tom63005/APF2SD/img/APF2SD-Fron-Back-Bare-G_20131016_144659.jpg

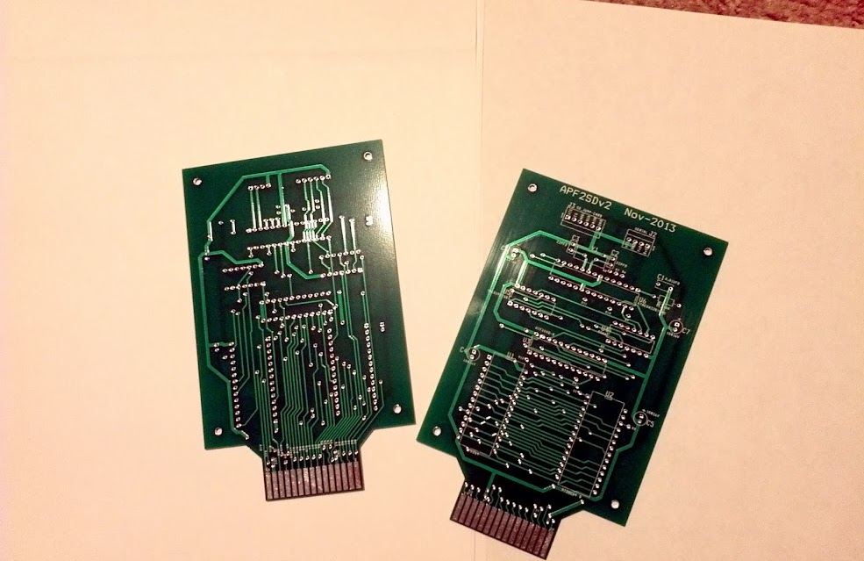
img/APF2SD-Fron-Back-Bare-G_20131016_144659.jpg
