tom63005/APF2SD/img/ShellP1.JPG

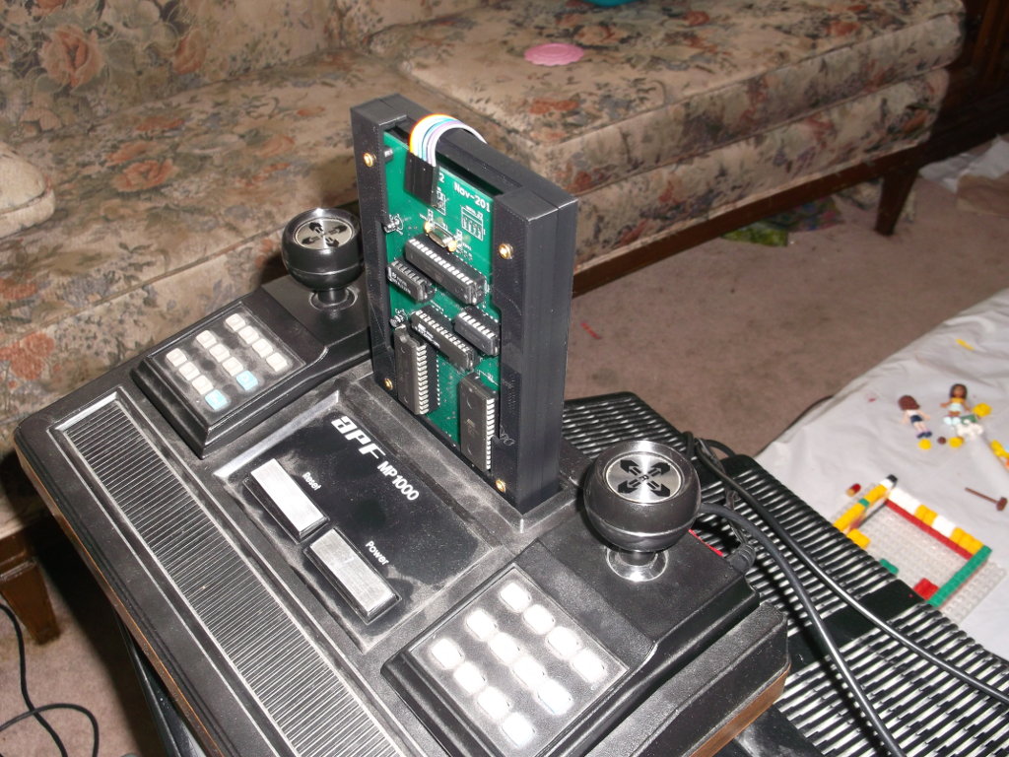
img/ShellP1.JPG
