tom63005/APF2SD/img/2layer-r1---for-Lance-gs.png

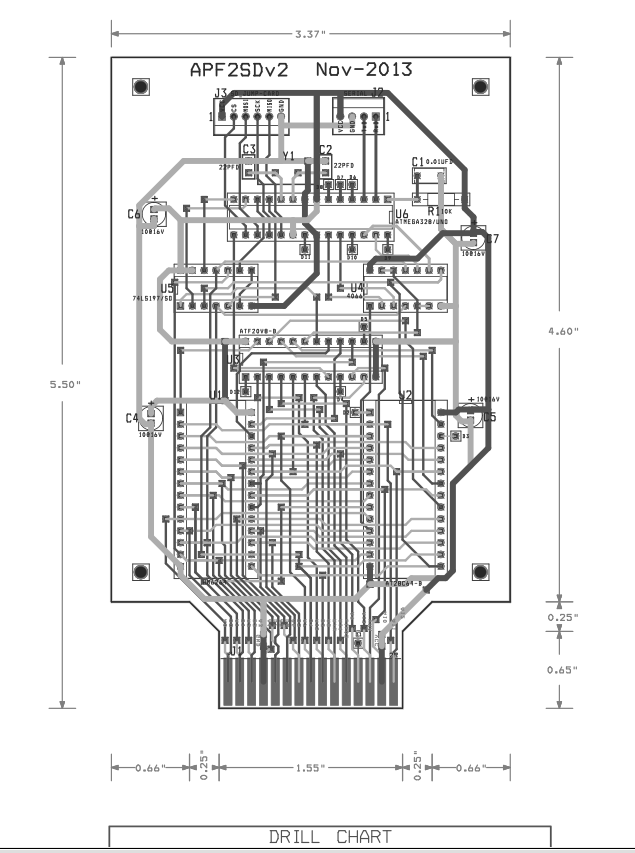
img/2layer-r1---for-Lance-gs.png
