tom63005/APF2SD/img/APF2SD-Schematic-Sept-23-2013.jpg

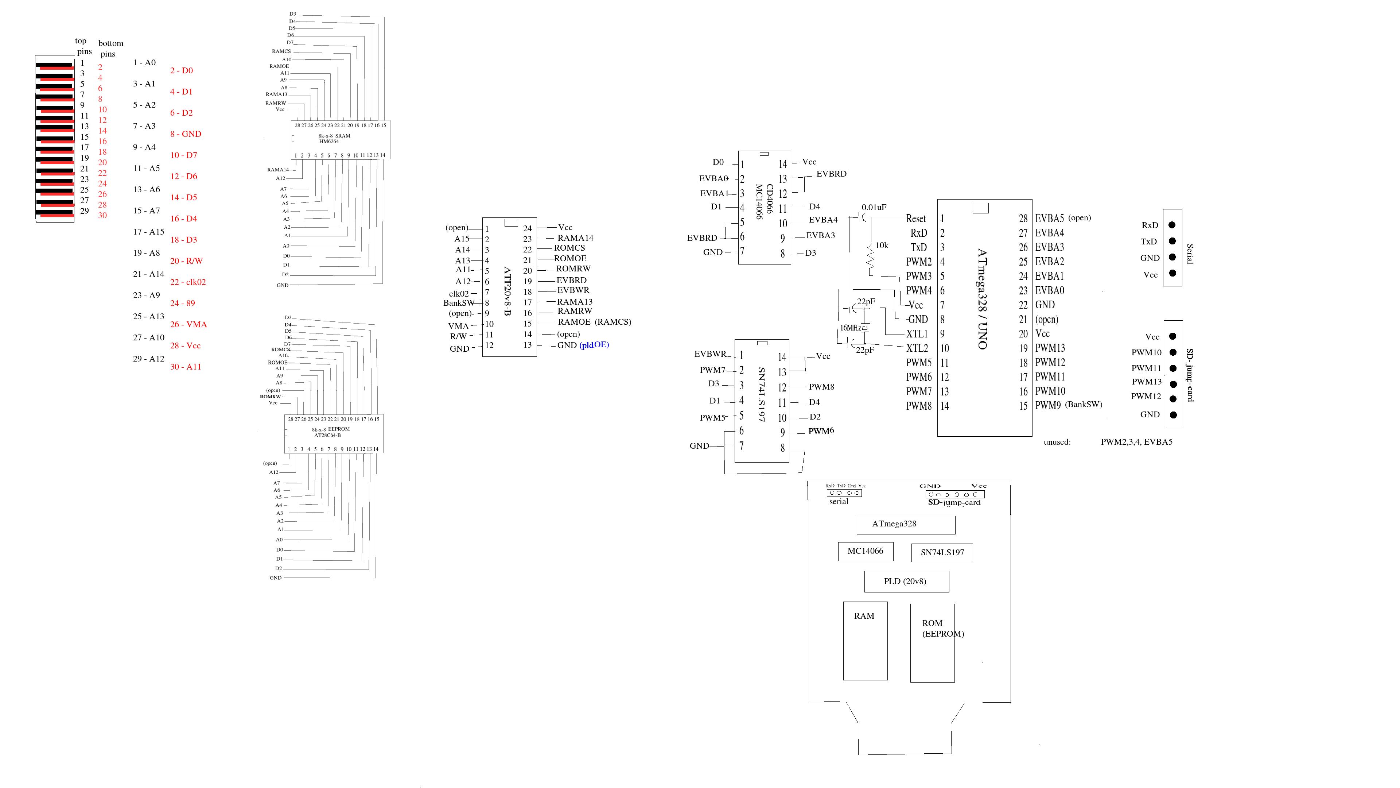
img/APF2SD-Schematic-Sept-23-2013.jpg
