tom63005/APF2SD/img/IMG_20131017_115455.jpg

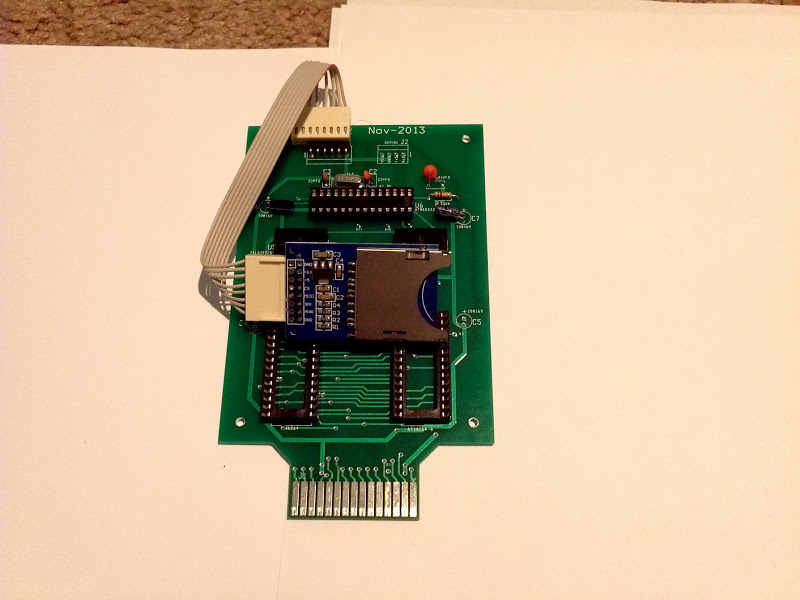
img/IMG_20131017_115455.jpg
