tom63005/APF2SD/img/SD-Serial-SST-09-28-2013-11h_35m_43s-AM.jpg

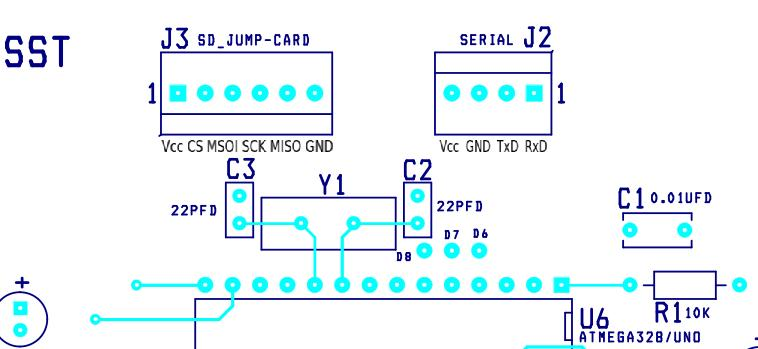
img/SD-Serial-SST-09-28-2013-11h_35m_43s-AM.jpg
