tom63005/APF2SD/img/ShellP2.JPG

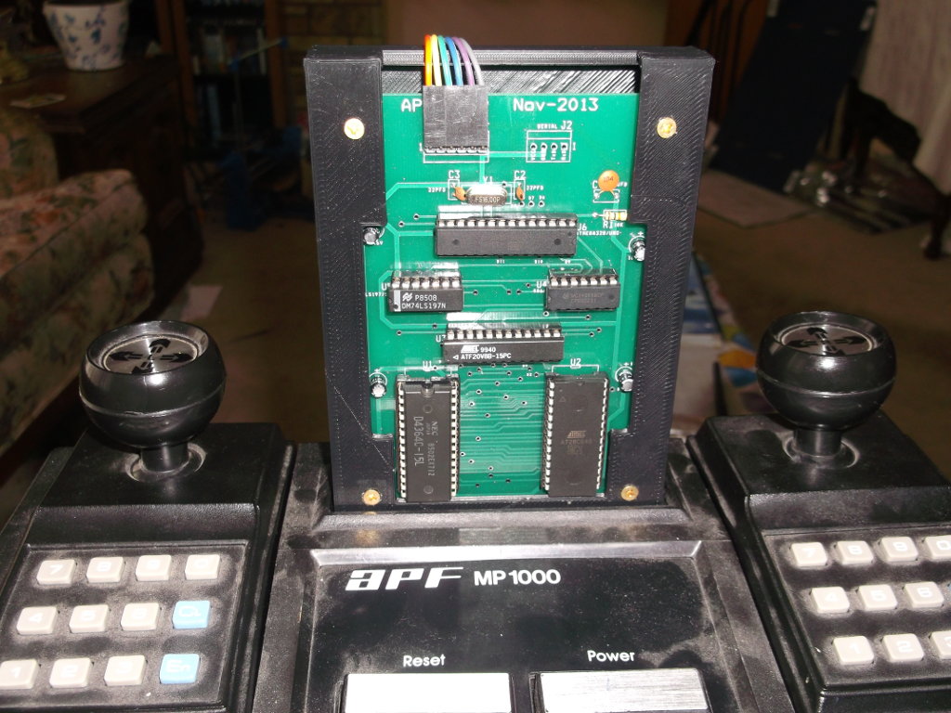
img/ShellP2.JPG
