tom63005/APF2SD/doc/Internet0302_B.pdf

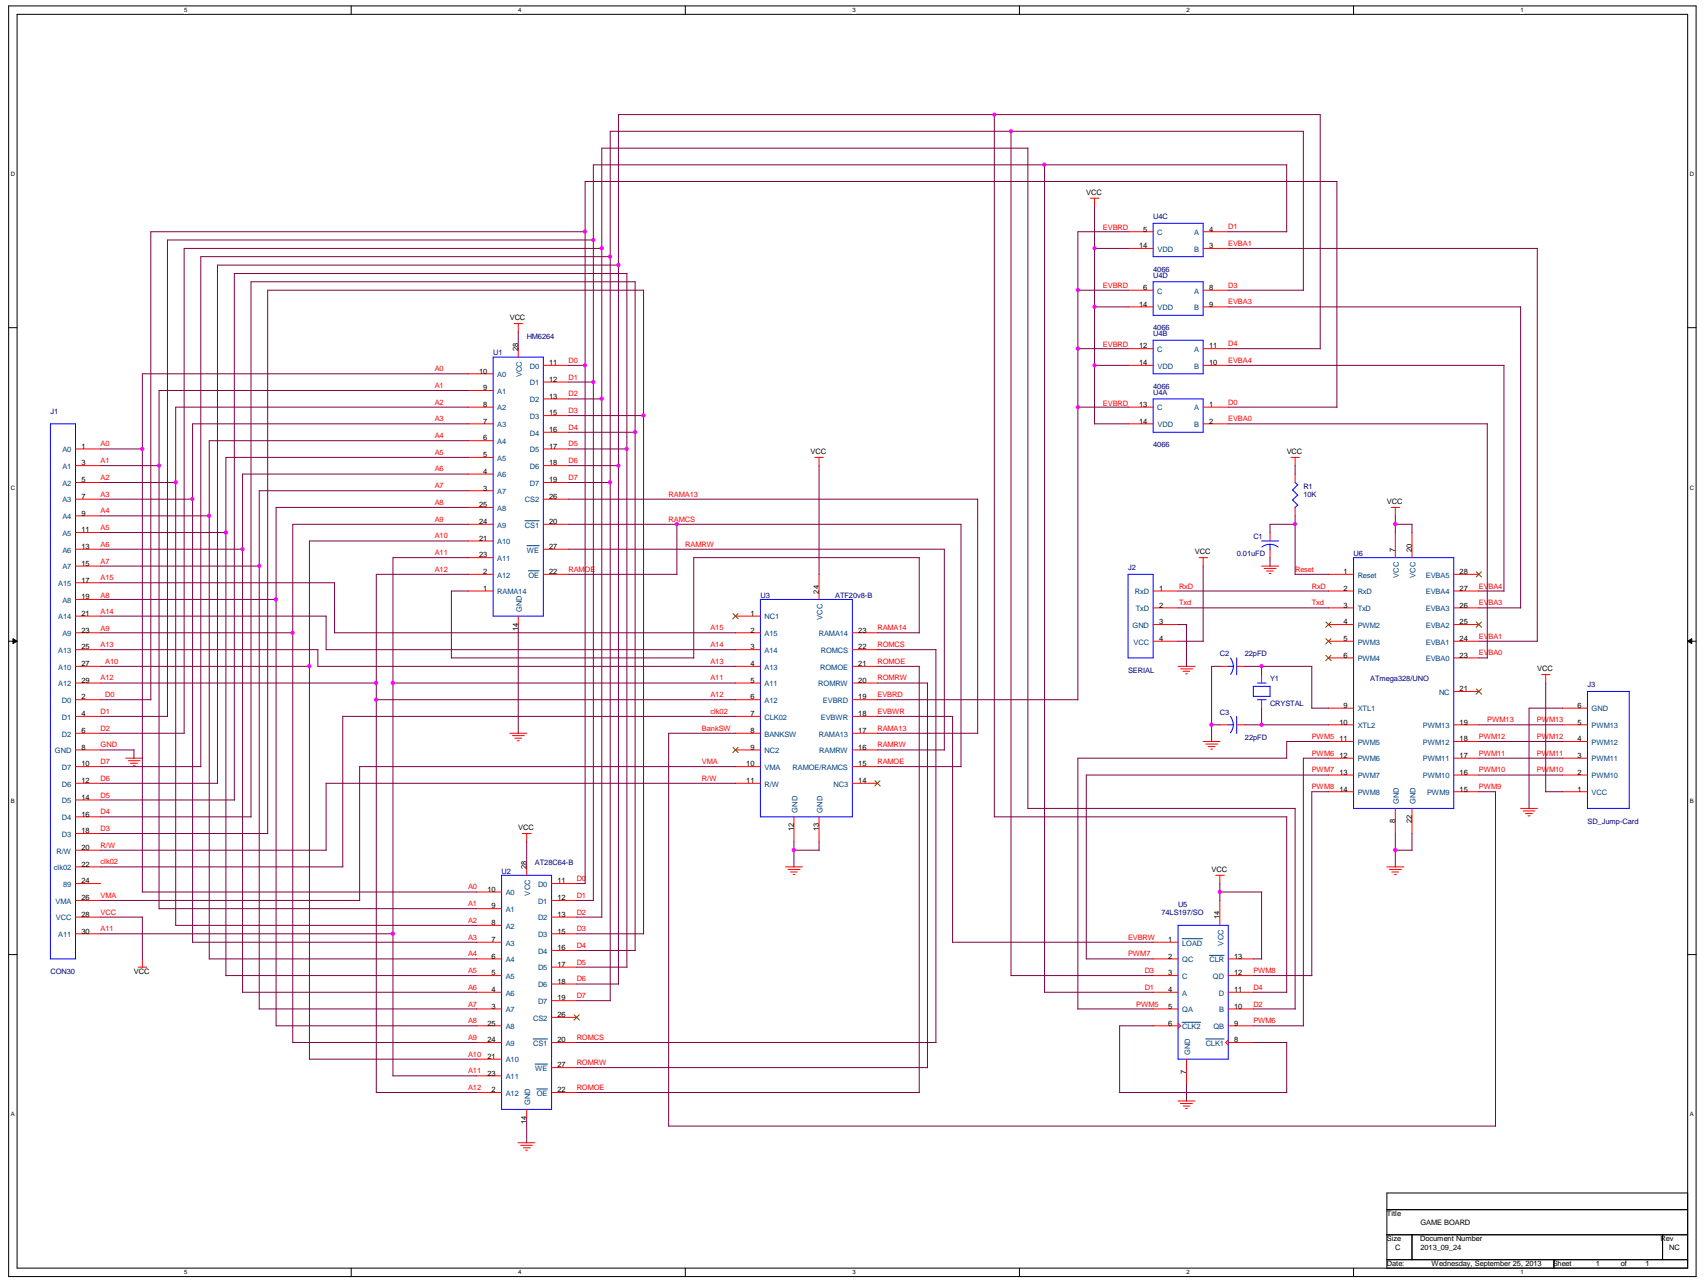
[picture p8: page 1]

2 | TxdTxd 3 | EVBA3 26

3 | | 25 24 EVBA1

27 | | A13A10 4 | | 21 ROMOE

A12 29 | A11 5 | | ROMRW 20

2 | A12D0 6 | | 19 EVBRD

PWM5 11 | | PWM12 18 | PWM12 | 4

PWM6 12 | | 17 PWM11 | PWM11 | 3

PWM7 13 | | PWM10 16 | PWM10 | 2

PWM8 14 | | 15 PWM9 | | 1

22 clk02

26 VMA

A10 21 | 27 ROMRW

Size C | Document Number 2013_09_24 | Rev NC

Date: | Sheet 1 of 1Wednesday, September 25, 2013
