tom63005/APF2SD/doc/Internet0302_A.pdf

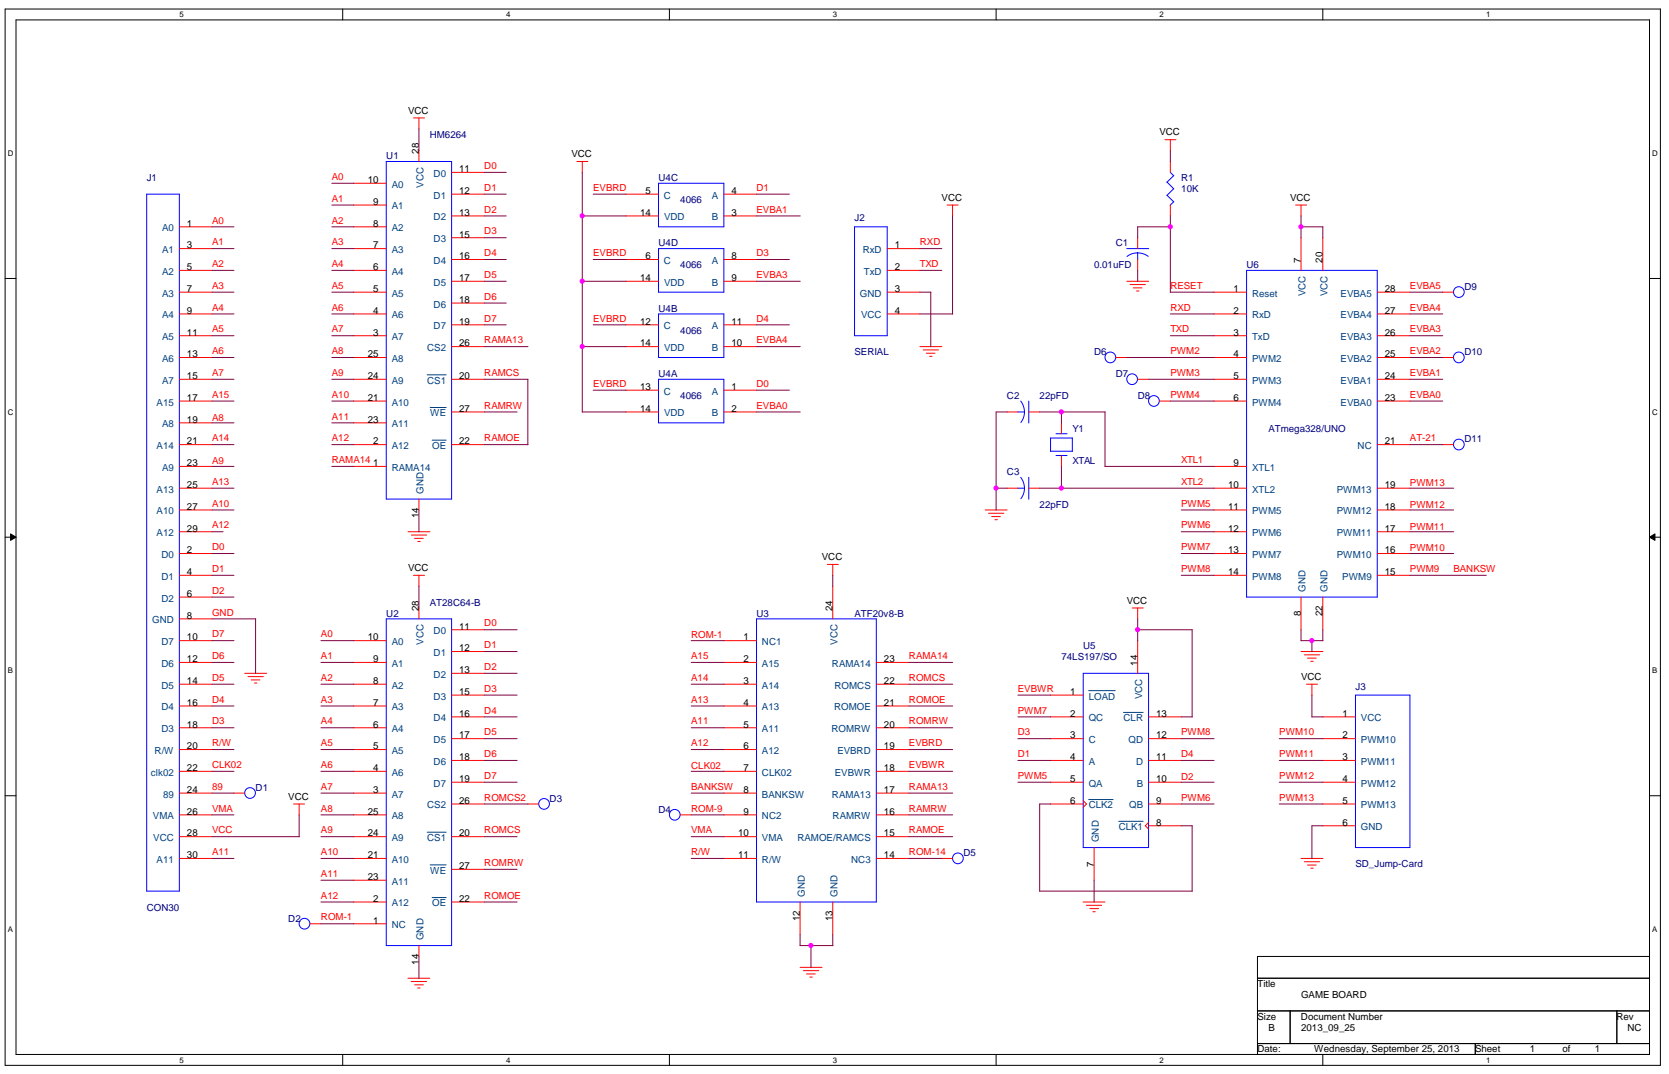
[picture p9: page 1]

Size B | Document Number 2013_09_25 | Rev NC

Date: | Sheet 1 of 1Wednesday, September 25, 2013
