tom63005/APF2SD/(threads)

Thread 1 (2023-12-07):

Missing Gerber Files for Copper Layers/Solder Mask/Silkscreen Bottom/Drill Drawing

PigHillJimster, 2023-12-07:
Hi, I came across this project as a Reddit user found it and posted about it, and was asking for help viewing any CAD data.
When I, and another Reddit user looked into it we found that the Gerbers folder contains only the "readme" report file for the gerber output and a single gerber file for the top silkscreen layer.

What is missing are the gerber files for the two copper layers, two solder masks, bottom silkscreen and the drill drawing.
These are the missing files detailed below:

INTERNET0303_2LAYER.TOP = top copper
INTERNET0303_2LAYER.BOT = bottom copper
INTERNET0303_2LAYER.SMT = top solder mask
INTERNET0303_2LAYER.SMB = bottom solder mask
INTERNET0303_2LAYER.SSB = bottom silkscreen
INTERNET0303_2LAYER.DRD = drill drawing

Would you happen to have these or the Eagle file?
I am a PCB CAD Engineer, IPC CID+ qualified, and have over 28 years experience. If you need the design CADed up I can do it in Pulsonix and let you have the binary data if you have the gerber files. If these are missing and unobtainable I can recreate but this would take longer and would be when I have free time to spend on it, so I could not commit to any specific timescale, but I'd be willing to have a look.
